ArmDeveloperEcosystem/universal-sbc-rack-mount-system-for-4u-chassis/cad-files/Rack and Dock v2 v74_Bay Cover.stl

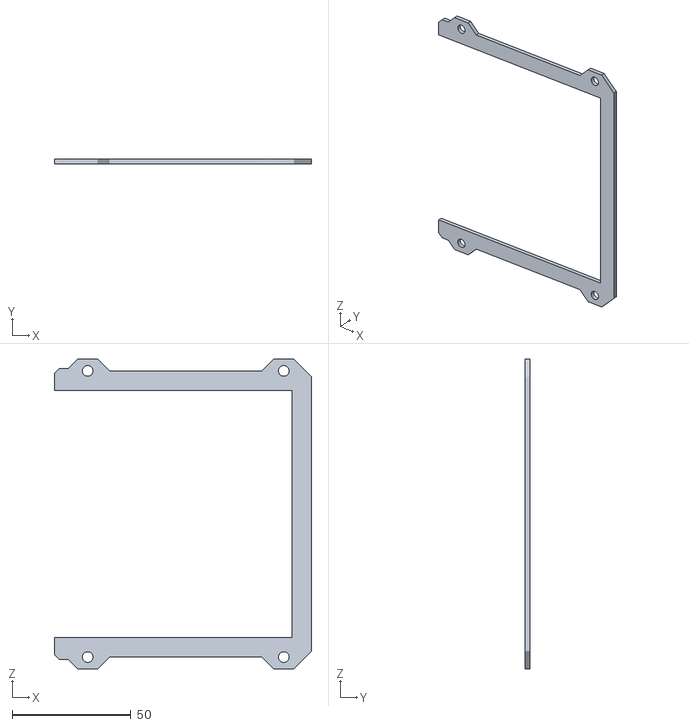
[picture p1: CAD file, 2023-06-21]
cad-files/Rack and Dock v2 v74_Bay Cover.stl
108.2 x 2.00 x 130.4
