ArmDeveloperEcosystem/universal-sbc-rack-mount-system-for-4u-chassis/cad-files/Rack and Dock v2 v74_Standoff.stl

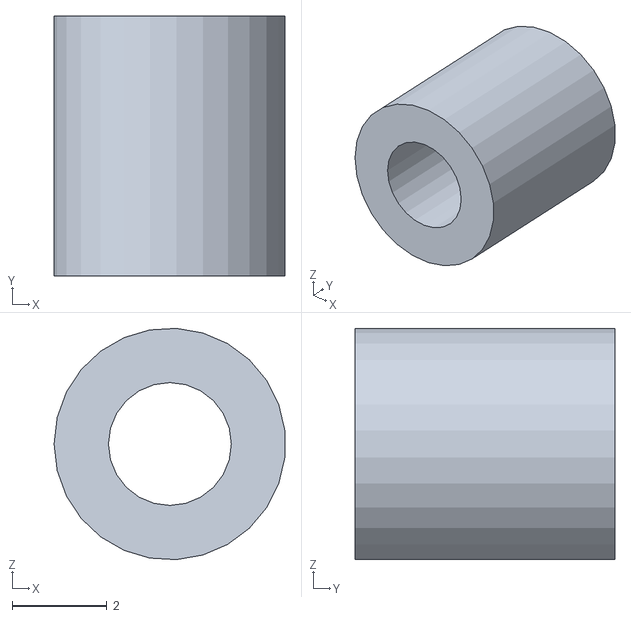
[picture p2: CAD file, 2023-06-21]
cad-files/Rack and Dock v2 v74_Standoff.stl
4.88 x 5.50 x 4.89
