ArmDeveloperEcosystem/universal-sbc-rack-mount-system-for-4u-chassis/cad-files/Rack and Dock v2 v74_Standoff for End Frame.stl

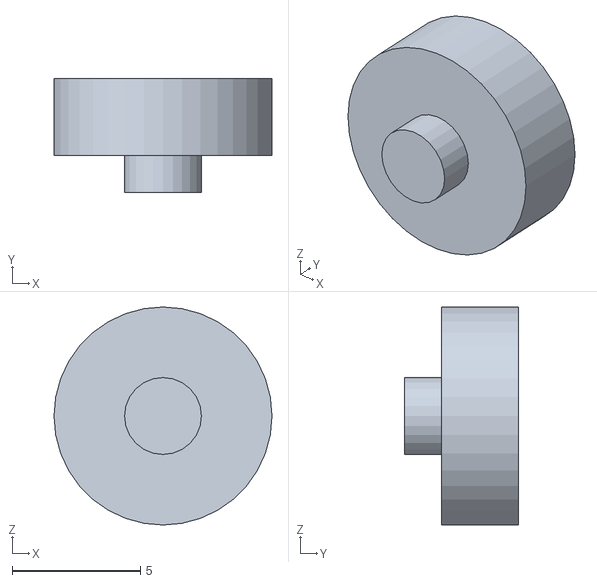
[picture p3: CAD file, 2023-06-21]
cad-files/Rack and Dock v2 v74_Standoff for End Frame.stl
8.50 x 4.45 x 8.50
