ArmDeveloperEcosystem/universal-sbc-rack-mount-system-for-4u-chassis/cad-files/Rack and Dock v2 v74_End Frame B.stl

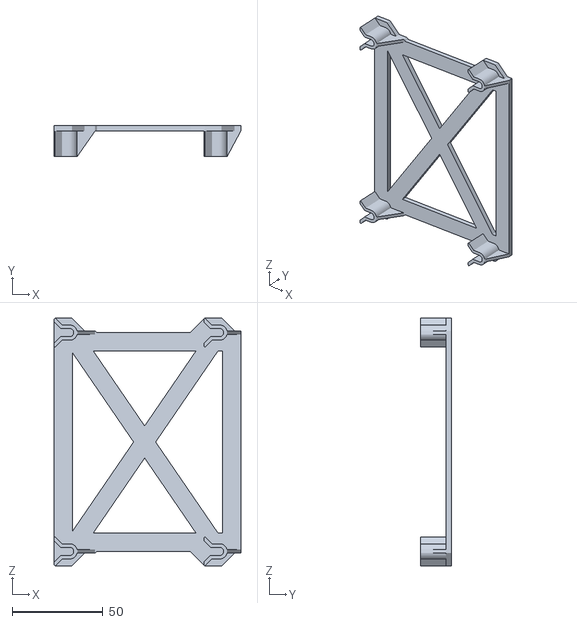
[picture p4: CAD file, 2023-06-21]
cad-files/Rack and Dock v2 v74_End Frame B.stl
102.7 x 17.0 x 136.5
