ArmDeveloperEcosystem/universal-sbc-rack-mount-system-for-4u-chassis/cad-files/Rack and Dock v2 v74_Card Plate.stl

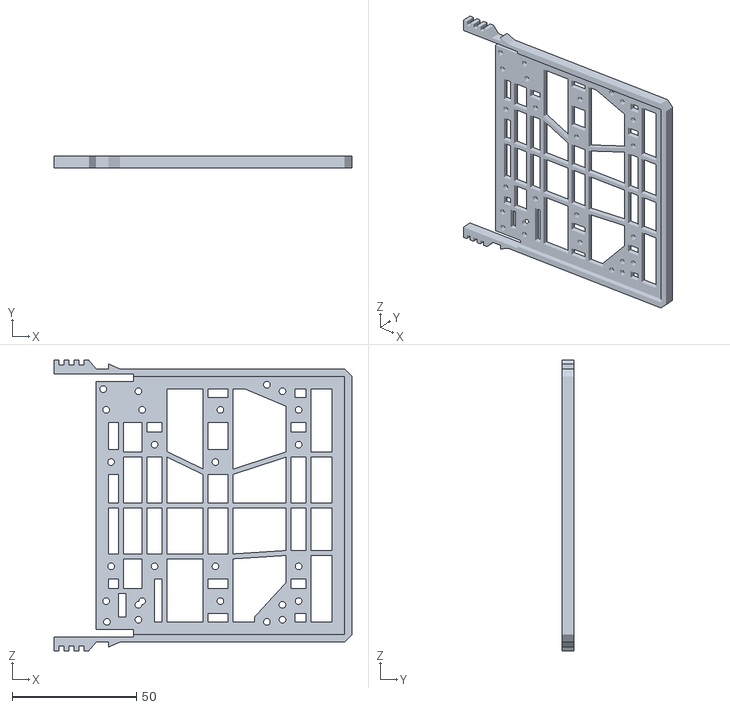
[picture p5: CAD file, 2023-06-21]
cad-files/Rack and Dock v2 v74_Card Plate.stl
120.0 x 5.00 x 117.0
