ArmDeveloperEcosystem/universal-sbc-rack-mount-system-for-4u-chassis/cad-files/Rack and Dock v2 v74_Bay Body.stl

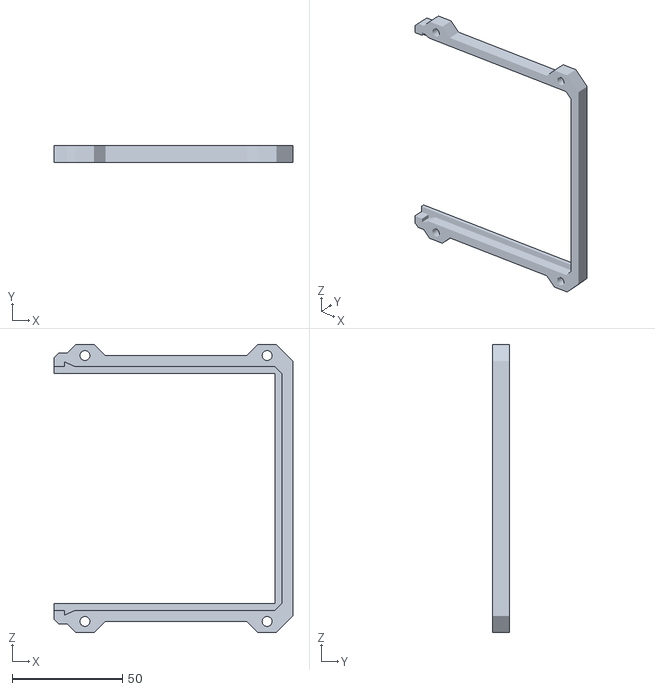
[picture p6: CAD file, 2023-06-21]
cad-files/Rack and Dock v2 v74_Bay Body.stl
108.2 x 7.50 x 130.4
