ArmDeveloperEcosystem/universal-sbc-rack-mount-system-for-4u-chassis/cad-files/Rack and Dock v2 v74_End Frame A.stl

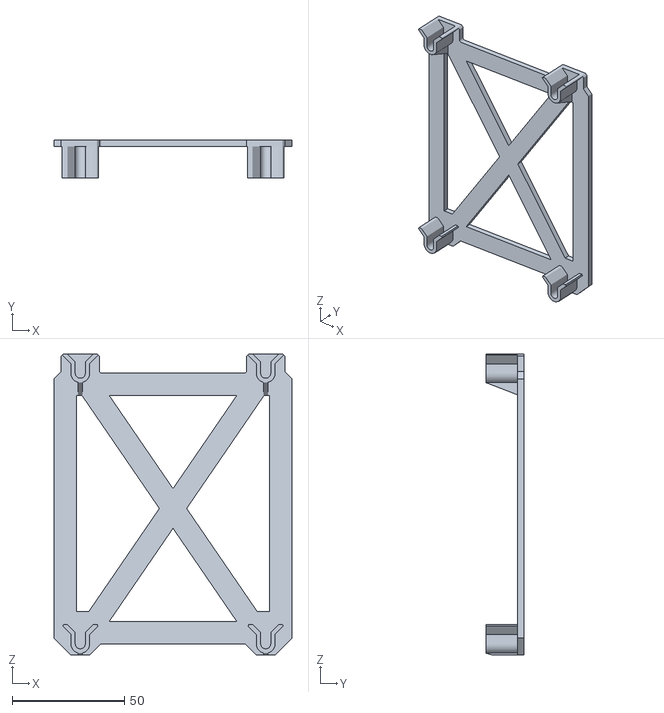
[picture p7: CAD file, 2023-06-21]
cad-files/Rack and Dock v2 v74_End Frame A.stl
105.9 x 17.0 x 133.9
