ArmDeveloperEcosystem/universal-sbc-rack-mount-system-for-4u-chassis/cad-files/Rack and Dock v2 v74_Spacer 40 mm.stl

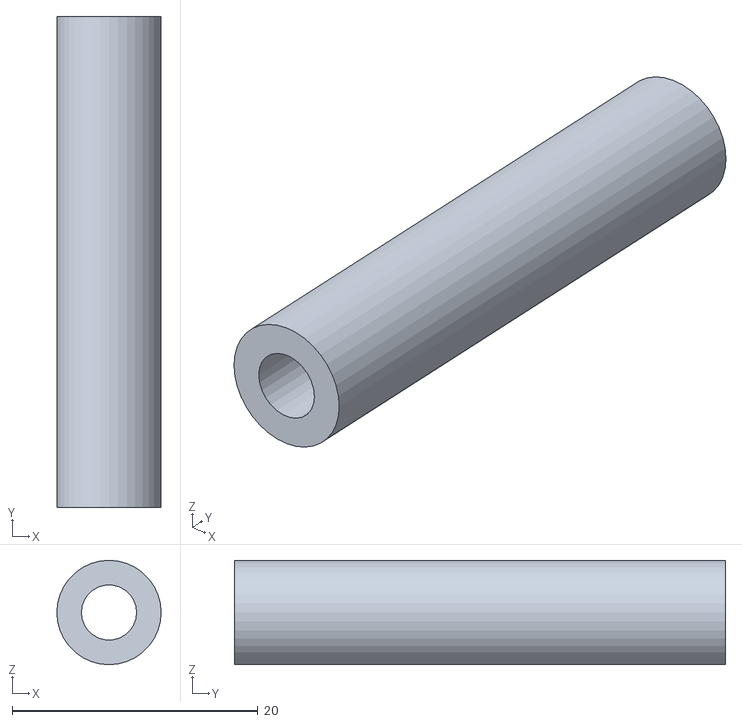
[picture p8: CAD file, 2023-06-21]
cad-files/Rack and Dock v2 v74_Spacer 40 mm.stl
8.50 x 40.0 x 8.50
