ArmDeveloperEcosystem/universal-sbc-rack-mount-system-for-4u-chassis/cad-files/Rack and Dock v2 v74_Spacer 35 mm.stl

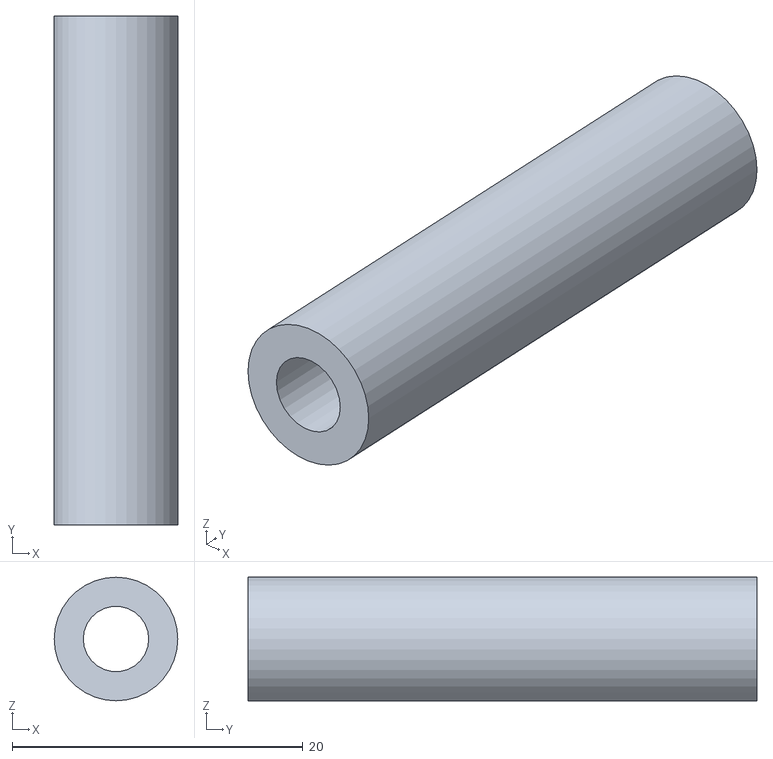
[picture p9: CAD file, 2023-06-21]
cad-files/Rack and Dock v2 v74_Spacer 35 mm.stl
8.50 x 35.0 x 8.50
