ArmDeveloperEcosystem/universal-sbc-rack-mount-system-for-4u-chassis/(list of files, cad)

Other CAD files:
cad-files/Rack and Dock v2 v74.f3d
