ArmDeveloperEcosystem/universal-sbc-rack-mount-system-for-4u-chassis/Assembly Instruction for ARM Chassis Bays.pdf

### Assembly Instruction for ARM Chassis Bays

Part List:
- 8-32 stainless steel threaded rod at least 405 mm long. 4 x 405 mm long rods will be required per bay row. Part used in prototype: https://www.mcmaster.com/98847A009/
- 8-32 stainless steel hex nut. 8 per bay row. Part used in prototype: https://www.mcmaster.com/91841A009/
- 8-32 stainless steel wing nut. 8 per bay row. Part used in prototype: https://www.mcmaster.com/92001A291/
- #8 stainless steel washer. 8 per bay row. Part used in prototype:https://www.mcmaster.com/90107A010/
- 3D printed bay body. Number required per bay depends on the spacer size used.
- 3D printed bay cover. Same number as the bay body.
- 3D printed spacers. Number required per bay depends on the spacer size used.
- 3D printed end pieces. 2 per bay row.
- 3D printed snap-in feet for the end pieces.

Assembly Steps:
1. Wash the grease off the threaded rods with soap and hot water. They will almost certainly arrive coated in grease, and these are stainless steel parts being used in a dry environment. Leaving it on will just end up with the whole project being greasy.
2. Cut each rod to 405 mm long. If you haven’t done this before this is the best way to do so that I’ve used if you’re using a hacksaw: https://www.familyhandyman.com/article/cutting-threaded-rod/
3. Thread a hex nut around 15 mm in, doing so on the side you cut, followed by a wing nut with the wings facing inward / towards the long side. The exact distance doesn’t matter as long as all the hex nuts are roughly the same. Don’t worry about getting them exactly the same now, as it is better to fine tune it after all the parts are together.

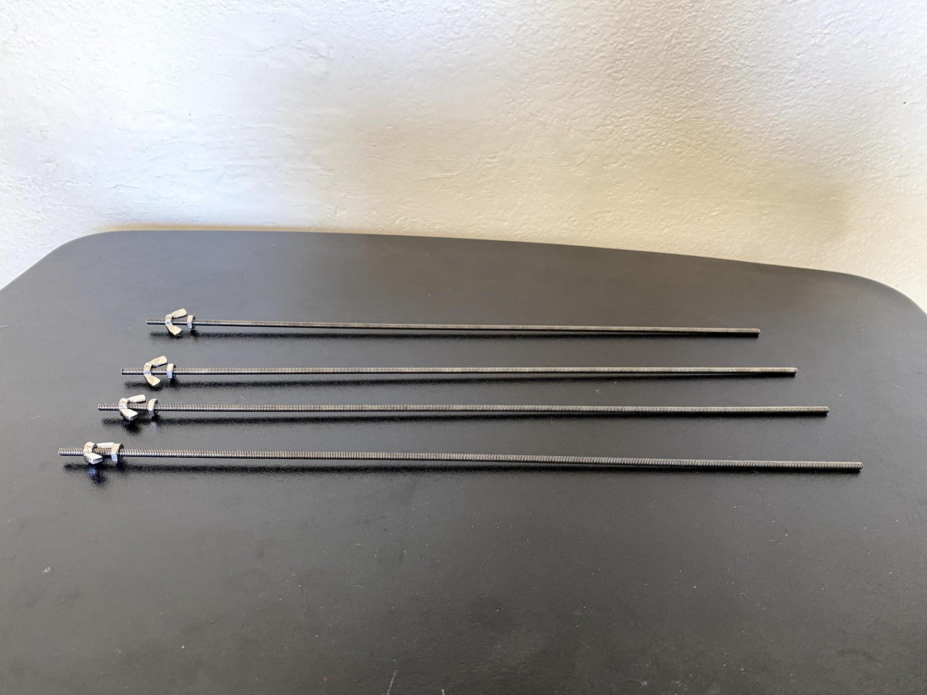
[picture p10: figure]

4. Slide the rods into the first bay body with the hex nuts pressing against the back of the bay body piece.

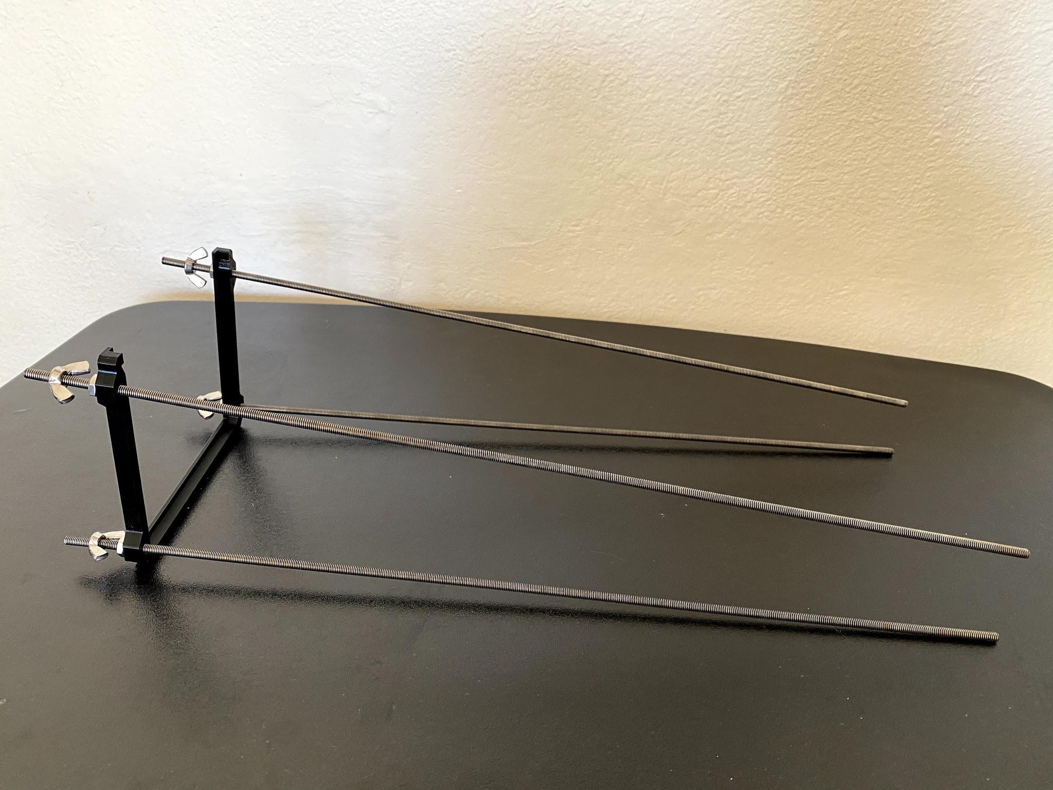
[picture p11: figure]

5. Slide down the bay cover.

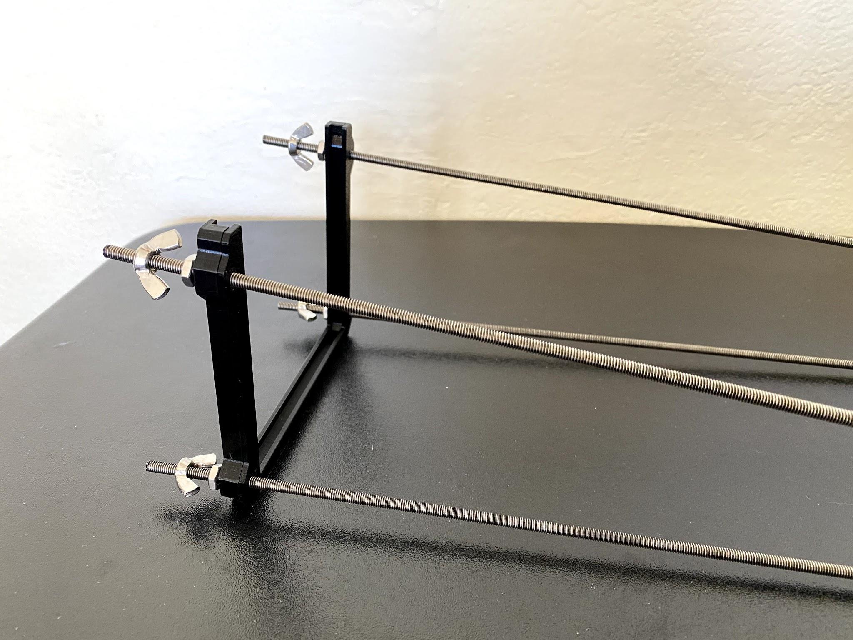
[picture p12: figure]

6. Followed by four spacers of the same length.

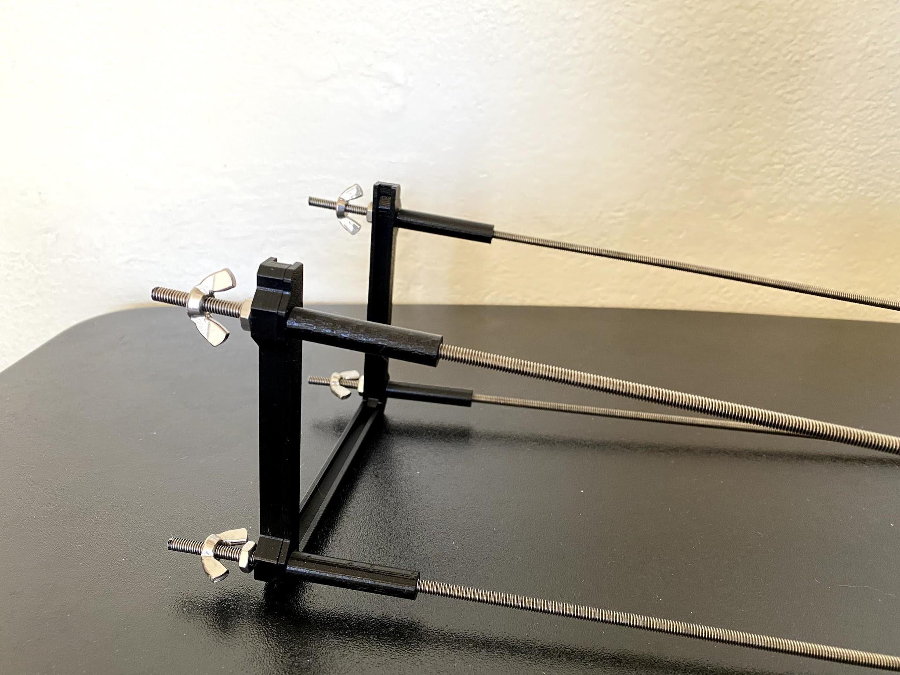
[picture p13: figure]

7. Repeat these steps until you’ve almost entirely covered the rods. It is easier to do this with the entire thing rotated so the rods point upward.

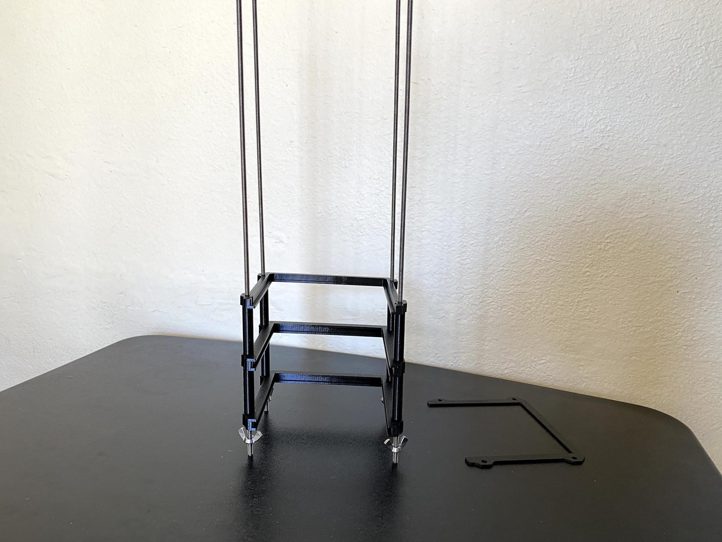
[picture p14: figure]
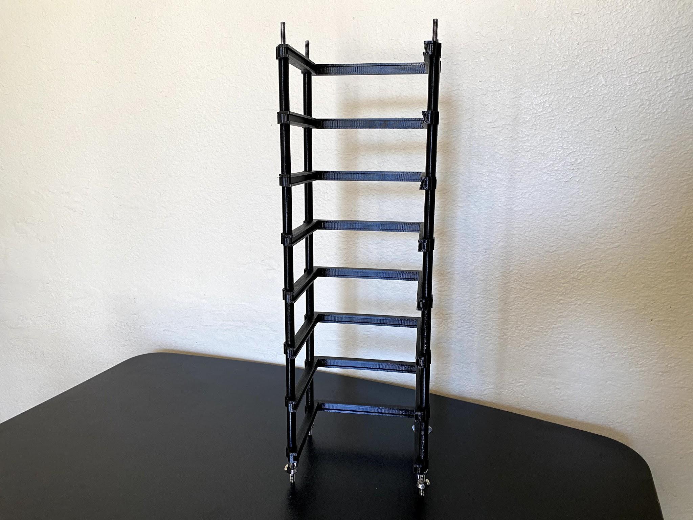
[picture p15: figure]

8. Thread a hex nut onto each rod. At this point it is a good idea to fine tune the distance so that the hex nuts on one side are exactly the same distance from the end. Then thread in a wing nut with the wings facing inwards followed by a washer next to each wing nut.

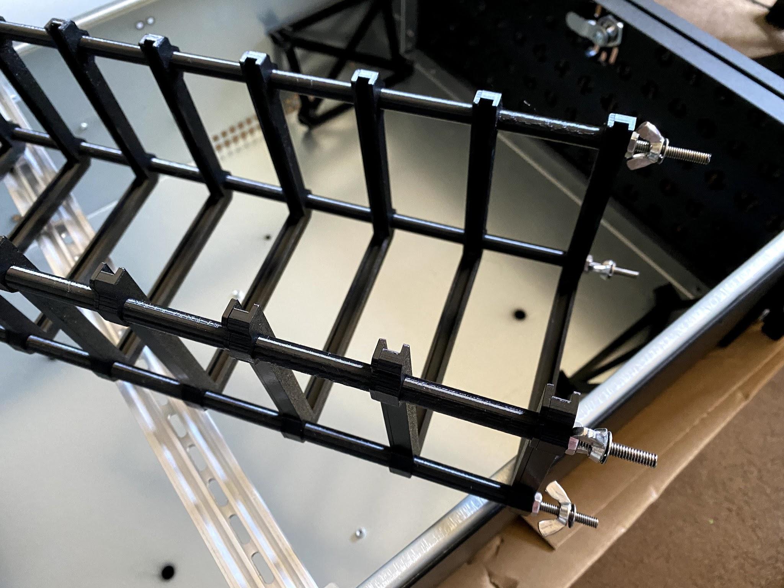
[picture p16: figure]

9. Snap the circular feet into the back of the end pieces.

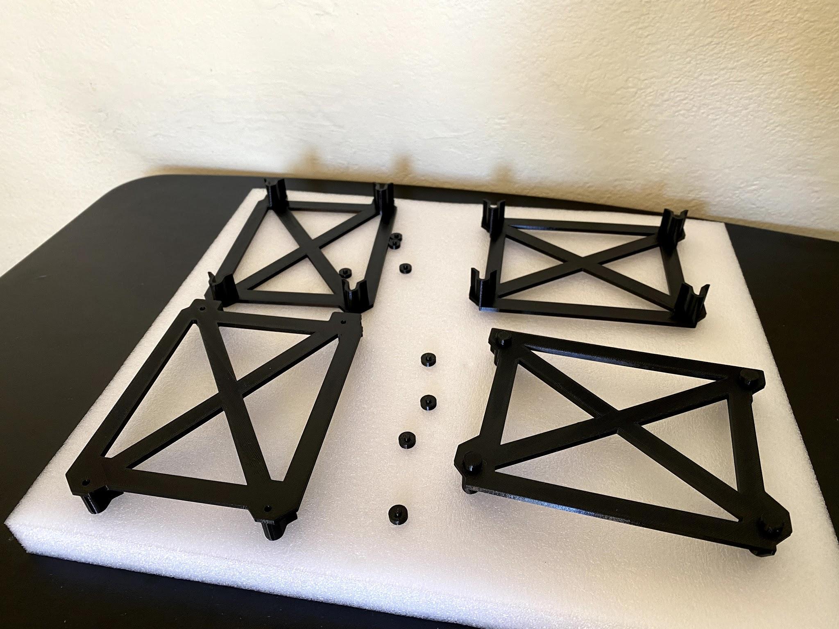
[picture p17: figure]

10. Place end pieces into the rack.

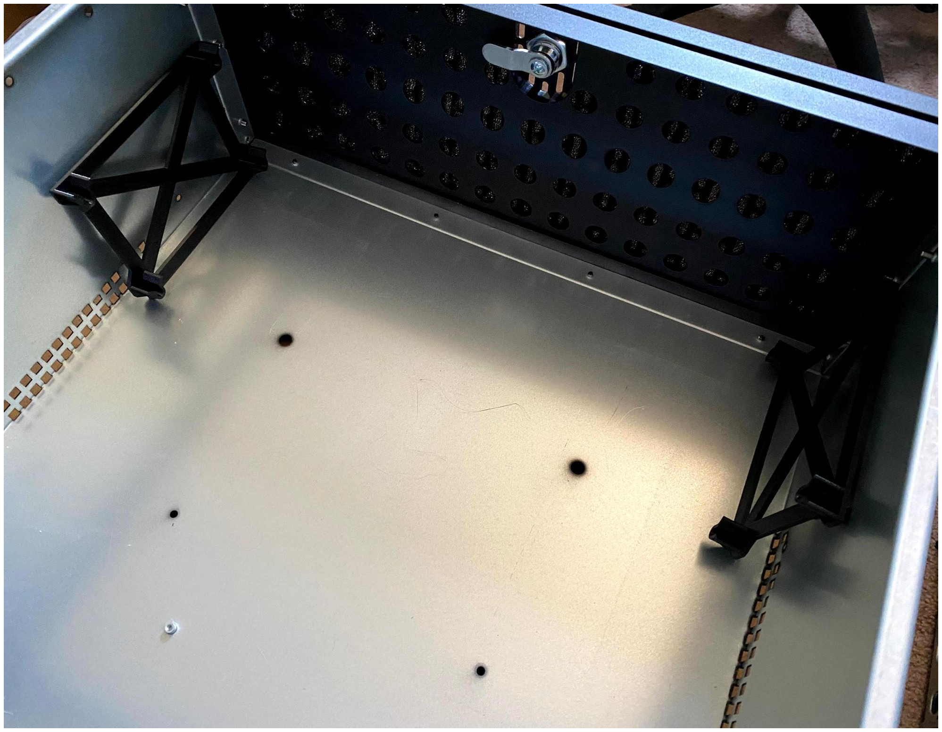
[picture p18: figure]

11. Drop the unit into the slots on the end pieces and tighten the wing nuts until they just firmly press into the end pieces. Don’t over tighten to the point of the rods bowing.

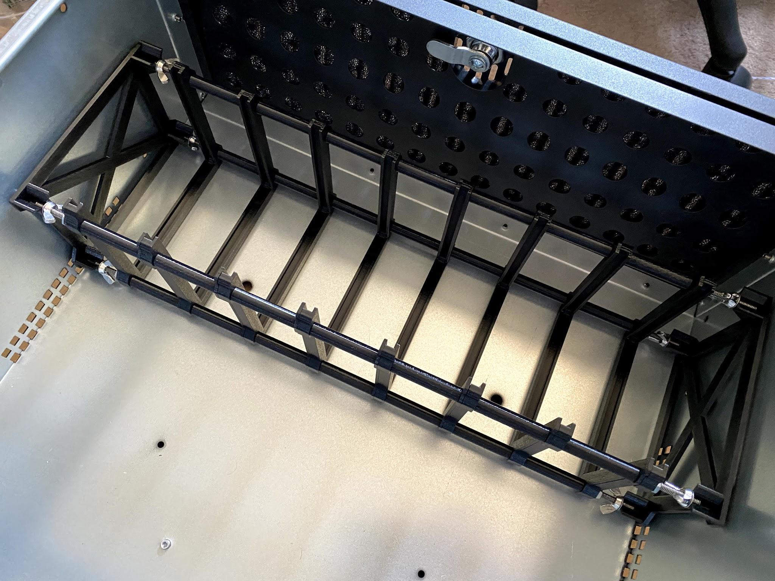
[picture p19: figure]
