ArmDeveloperEcosystem/universal-sbc-rack-mount-system-for-4u-chassis/(commit log)

2023-06-21 Initial commit, add all cad files
    [Rack and Dock v2 v74.f3d, Rack and Dock v2 v74_Bay Body.stl, Rack and Dock v2 v74_Bay Cover.stl, Rack and Dock v2 v74_Card Plate.stl, Rack and Dock v2 v74_End Frame A.stl, Rack and Dock v2 v74_End Frame B.stl, Rack and Dock v2 v74_Spacer 35 mm.stl, Rack and Dock v2 v74_Spacer 40 mm.stl]
2023-06-21 Add pdf of bay assembly instructions
